bigtreetech/Raspberry-Pad/Pad5/3D/README.md

* The fixing screw  of the screen is M2.5x6mm
* The fixing screws of the upper and lower covers are three M3x6mm countersunk screws and hex nuts
