bigtreetech/Raspberry-Pad/Pad5/3D/Pad5+Case.STEP

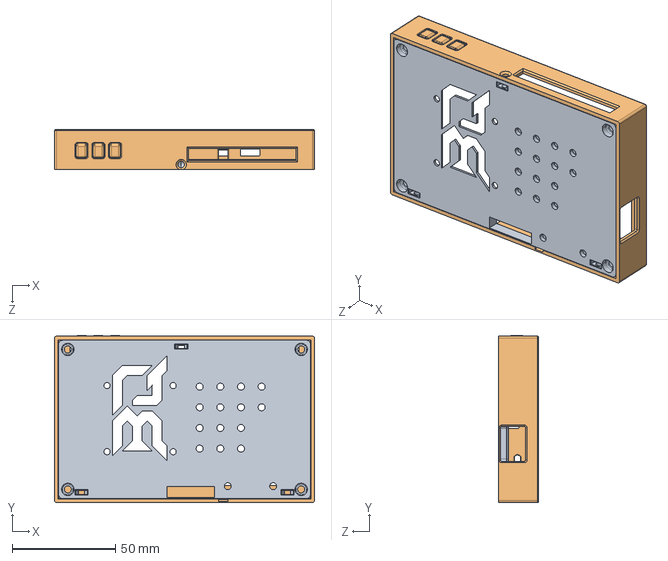
[picture p17: CAD file, 2022-09-15]
Pad5/3D/Pad5+Case.STEP
125.9 x 81.1 x 19.5 mm
