bigtreetech/Raspberry-Pad/(threads)

Thread 1 (2022-03-26):

GPIO pinout

cakeslob, 2022-03-26:
Can you provide some kind of pinout document or some label for the 40 pin GPIO? A document would be helpful, thank you.

jrgGearbox3d, 2022-04-05:
I am also looking for this.  The manual states to hook 5V to Pin 40, which is not typically the GPIO layout for a CM4 / PI.  Based on this I would guess that the pins are numbered backward from a typical 40PIN PI GPIO.

It would be nice to see the real GPIO and circuit before smoking a nice IPS screen.

bigtreetech, 2022-04-07:
Hello, https://github.com/bigtreetech/Raspberry-Pad/commit/2a0127b8a28db4e08ce698afd2b463529ae75a97 have updated the the pin out description of 40 pin GPIO on manual, Please check.

Closed 2022-04-10.

Thread 2 (2022-04-02):

EEPROM_NW Switch Use.

madmaxed, 2022-04-02:
Is there information on what the EEPROM_NW switch is used for?  I don't see reference to it in any of the documentation.

othermod, 2022-04-05:
It's the EEPROM write protect. Check out section 2.18 in the link below
[https://datasheets.raspberrypi.com/cm4/cm4-datasheet.pdf ](https://datasheets.raspberrypi.com/cm4/cm4-datasheet.pdf )

Thread 3 (2022-04-15):

Control Display Backlight?

lalten, 2022-04-15:
Hi, how can I control the Raspberry Pad 5's display backlight and power?

I'm on `2022-04-04-raspios-bullseye-arm64-lite` with Kernel 5.15.32-v8+, running KlipperScreen (installed via [kiauh](https://github.com/th33xitus/kiauh))

```
❯ cat /boot/config.txt | grep "^\w"
dtparam=spi=on
dtparam=audio=on
camera_auto_detect=1
display_auto_detect=1
dtoverlay=vc4-kms-v3d
max_framebuffers=2
arm_64bit=1
disable_overscan=1
otg_mode=1
arm_boost=1
dtoverlay=dwc2,dr_mode=host
dtparam=i2c_vc=on
dtoverlay=i2c-rtc,pcf8563,i2c_csi_dsi
```
`/boot/dt-blob.bin` is also installed as per the manual.

A sysfs entry is present:
```
❯ ls /sys/class/backlight/10-0045/
actual_brightness  bl_power  brightness  device  max_brightness  power  scale  subsystem  type  uevent
```
But sending commands has no effect. (using [rpi-backlight](https://github.com/linusg/rpi-backlight)):
`sudo rpi-backlight -p off /sys/class/backlight/10-0045`
Display stays on and at 100% brightness...

Darkgoppi, 2022-09-01:
I have the same behavior as described by lalten. I tried to switch the back light power by manipulating the `bl_power` file in `/sys/class/backlight/10-0045/` based on the status of xscreensaver. Is there any way to control the back light brightness and power?

Darkgoppi, 2022-09-10:
Hi, I contacted the BIQU support on this issue/question. This is the answer from them:

"Sorry, no. This is a constant light that the screen lights up."

So it seems, that it is not intended to control the backlight at all, which is a pity.

sl1pkn07, 2023-04-23:
and via buttons hardware? (three in the corner)

kbenyous, 2024-03-28:
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

Hello,
According to their technical docs ( schematics https://github.com/bigtreetech/Raspberry-Pad/blob/master/Pad5/Hardware/BIGTREETECH%20Raspberry%20pad%205-SCH.pdf ) the 3 hardware buttons (BRI+, BRI- and LCD_DIR) are plugged to some pins of a ARM Cortex M0 MCU. So it could be software-controlled, if BTT would implement it in the firmware of this MPU !

Thread 4 (2022-05-15):

does not show on network

Machine73, 2022-05-15:
Purchased 2 pad5's and neither will connect to network. SD cards with os installed work perfectly in a standard PI. But once installed in the PAD5 no connection,

othermod, 2022-05-15:
It is the wired LAN port you're having trouble with? I've been using one of these for a while and I have it wired to a decent network switch that works fine with it. I recently tried using it with a cheap switch, and it can't get an IP address with it connected to that switch. Running ifconfig just shows a standard 169.254 address.  Just curious whether we are having the same problem.

Machine73, 2022-05-15:
No. Over wifi. And they are the CM4 w/ wifi.

blooest, 2022-05-18:
You haven't really given us any information. My best guess is that you got a CM4 with eMMC that will not boot at all from SD. Connect an HDMI display so you can see what's going on with it. Other than that, the CM4 wifi has nothing at all to do with the Raspberry Pad so you're probably better off seeking information from a more generalized/larger RPi community.

@othermod To note, I'm here chasing the same problem. The switch I'm working with is a known-good Unifi box, though. It's detecting the client, providing an activity light on its end, but I get a whole lot of nothing on the Pi side and then a 169.254 zeroconf address. Was beginning to think the port was dead, but I guess I'll have to move things around and try another switch. Maybe we should open a separate issue?

jstebbins, 2022-08-19:
Confirming same behavior as @blooest. I am also connected to a Unifi switch (model US-8-60W). Fails to link at GB speed, but forcing link to 100BASE-T works.

When failing to link at GB speed, I see an initial attempt to bring the link up in the system logs, then the link goes down and does not connect.  The green light on the ethernet connector of the Raspberry Pad blinks at a slow regular interval.

blooest, 2022-08-19:
@jstebbins Sorry, I actually never circled back to this thread -- BTT support actually did solve that issue for me; in the end, I had to [physically desolder three SMD components on the board](https://imgur.com/a/lClHPaa), but the gigabit PHY worked flawlessly afterwards. Hope that helps!

jstebbins, 2022-08-19:
@blooest Thanks! Did they provide any additional details regarding the nature of the problem? Do those components affect any other functionality? Would hate to fix one thing only to render something else non-functional :grin:

blooest, 2022-08-19:
@jstebbins They weren't _too_ particular to me as an end user, but as long as you _only_ touch those three, it shouldn't affect anything else. They're resistors across the traces from the Magjack to the breakout for the PHY on the CM4. They don't physically interact with any other components. From what I've inferred (read: **I'm just another customer making educated guesses**), they have/had multiple suppliers for the Magjack itself, and the ones they prototyped with didn't have resistance built in, which led them to add these resistors, but the ones they shipped, at least to the two of us, do, and that extra resistance is causing this issue.

jstebbins, 2022-08-19:
> the ones they prototyped with didn't have resistance built in, which led them to add these resistors, but the ones they shipped, at least to the two of us, do

Ahh, that makes sense. Seen that happen before. Thanks for passing along the info.

jaymcd, 2022-10-25:
I have no wifi either - error on boot says bcrm_pci link down

FriendlyNGeeks, 2024-07-26:
> @jstebbins Sorry, I actually never circled back to this thread -- BTT support actually did solve that issue for me; in the end, I had to [physically desolder three SMD components on the board](https://imgur.com/a/lClHPaa), but the gigabit PHY worked flawlessly afterwards. Hope that helps!

I cant believe this worked, but it makes sense from a prototype!!!! Nerve wrecking getting those itty bitty resistors

Thread 6 (2022-06-21):

pinout documentation missing

troyness, 2022-06-21:
I want to connect my hardware to a CAN bus. There is no documentation on what the USB C input pinout is to do this. Sent an emails to support over the past few weeks with no response.

pnewb, 2022-12-01:
If you get a usb breakout board, you can grab the standard usb2 data pins and they'll be your CANH and CANL.  Can't recall which is which right now, but you have a 50/50 chance of getting it right, and if it's not right you won't damage anything.

It's a bit awkward because this is the same port you use to power the pad.  So having the breakout can be doubly helpful as you'll want to supply power in one direction, and run CAN in the other.

Thread 7 (2022-08-02):

CM4 2gb lite version, raspios, and usb ports

jaymcd, 2022-08-02:
I have the PAD 5 - I finally managed to get a CM4 ( 2GB lite version) I managed to get RaspiOS ( Raspian) installed. Even after following the instructions in the manual - including the overlay stuff I cannot for the life of me get the USB ports to be usable. Wondering what I am missing

OAltr, 2022-08-17:
Hi @jaymcd I had the exact same problem. What fixed it for me was setting the BOOT and BOTG switches to their off position. Had them on because I previously used a CM4 with eMMC.

brunoAmado, 2022-09-03:
installng [Fluiddpi 1.19](https://github.com/fluidd-core/FluiddPI/releases/tag/v1.19.0) using LITE Version(Micro SD card)
ssh already in image
add wpa credencials in fluiddpi-wpa-supplicant.txt
configure USB 2.0 Hub in config.txt file
verification of microswith (all off)
result:
Red light and Blue but no Green :(

Did I miss something ?

pl4nkt0n, 2022-09-04:
As described in the data sheet of the CM4 from Pi-Foundation and in the manual from BigTreeTech:

"With the Raspberry Pi OS the following has do be done to activate the USB-Ports for the CM4: To enable the USB 2.0 ports on the Compute Module 4, you need to edit the boot config file (/boot/config.txt) and add with the last row:

dtoverlay=dwc2,dr_mode=host

It is deactivated by default in the OS of RaspiOS to save energy.

brunoAmado, 2022-09-05:
Hi,

As I said in the last mail. I did the configuration as explained in the
BigTreeTech Manual.
Please see the attachments and video.

https://drive.google.com/file/d/1MA2Fw5SE6T7sgGQLoNIgWznggDXRX3d6/view?usp=sharing

Best Regards,

Bruno

---------- Forwarded message ---------
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

brunoAmado, 2022-09-06:
```
# For more options and information see
# http://rpf.io/configtxt
# Some settings may impact device functionality. See link above for details

# uncomment if you get no picture on HDMI for a default "safe" mode
#hdmi_safe=1

# uncomment the following to adjust overscan. Use positive numbers if console
# goes off screen, and negative if there is too much border
#overscan_left=16
#overscan_right=16
#overscan_top=16
#overscan_bottom=16

# uncomment to force a console size. By default it will be display's size minus
# overscan.
#framebuffer_width=1280
#framebuffer_height=720

# uncomment if hdmi display is not detected and composite is being output
#hdmi_force_hotplug=1

# uncomment to force a specific HDMI mode (this will force VGA)
#hdmi_group=1
#hdmi_mode=1

# uncomment to force a HDMI mode rather than DVI. This can make audio work in
# DMT (computer monitor) modes
#hdmi_drive=2

# uncomment to increase signal to HDMI, if you have interference, blanking, or
# no display
#config_hdmi_boost=4

# uncomment for composite PAL
#sdtv_mode=2

#uncomment to overclock the arm. 700 MHz is the default.
#arm_freq=800

# Uncomment some or all of these to enable the optional hardware interfaces
#dtparam=i2c_arm=on
#dtparam=i2s=on
#dtparam=spi=on

# Uncomment this to enable infrared communication.
#dtoverlay=gpio-ir,gpio_pin=17
#dtoverlay=gpio-ir-tx,gpio_pin=18

# Additional overlays and parameters are documented /boot/overlays/README

# Enable audio (loads snd_bcm2835)
dtparam=audio=on

# Automatically load overlays for detected cameras
camera_auto_detect=1

# Automatically load overlays for detected DSI displays
display_auto_detect=1

# Enable DRM VC4 V3D driver
dtoverlay=vc4-kms-v3d
max_framebuffers=2

# Disable compensation for displays with overscan
disable_overscan=1

[cm4]
# Enable host mode on the 2711 built-in XHCI USB controller.
# This line should be removed if the legacy DWC2 controller is required
# (e.g. for USB device mode) or if USB support is not required.
otg_mode=1

[all]

[pi4]
# Run as fast as firmware / board allows
arm_boost=1

[all]
# enable raspicam
start_x=1
gpu_mem=128
dtoverlay=dwc2,dr_mode=host

```

jaymcd, 2022-10-20:
still cannot get by usb ports to work. I even sent my cm4 back and they sent a new one... ???
pios installed screen working but getting usb to work - not so much. I am usb the USB-C for power does that matter ? It is plugged into a powered USB.

OAltr, 2022-10-20:
Just noticed this section in you config:

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

I'll have to check on my setup tomorrow, but I don't remember a cm4 section in mine. Maybe removing the org_mode=1 could help.

In the past I had a problem when adding any commands below a section (e.g. [cm] or [all]) and had to add it above any of those (but this might be a non issue and it used to be a different problem back then 😄)

jaymcd, 2022-10-25:
No USB or Wifi. Moved my CM4 over to a CMIO module board - USB works fine but not WIFI ( obviosuly a broadcom driver issue).
There is either something wrong with my PAD 5 or the instructins are incorrect. I have tried everything suggested to no avail. Anyone havea working image?

Thread 9 (2022-09-04):

STEP File corrupted?

pl4nkt0n, 2022-09-04:
Tried to open the [Pad5+Case.STEP] but it seems to be defect. No CAD program  and no STEP viewer (even online) can open it.
Can you please fix that?

Thread 11 (2022-11-17):

Unable to get the DSI1 Port working for the screen getting 404 error

dborio, 2022-11-17:
When I try to run the command from step 4.2 sudo wget https://datasheets.raspberrypi.com/cmio/dt blob disp1 cam1.bin O /boot/dt blob.bin I am getting a 404 Site not found error.  Please help.

lohriialo, 2024-11-24:
copy paste issue from PDF to terminal
Btw, firmware has moved to `/boot/firmware/dt-blob.bin` from `/boot/dt-blob.bin`
Following should work for anyone trying in 2024 on CM4 with Raspbery Pad 5
```
sudo wget https://datasheets.raspberrypi.com/cmio/dt-blob-disp1-cam1.bin -O /boot/firmware/dt-blob.bin
sudo reboot
```

Thread 13 (2023-01-07):

USB-C CAN bus Pinout Missing

Engineer997, 2023-01-07:
There isn’t a pinout diagram for the Raspberry Pad 5.
What pins are used for the CAN bus?

Engineer997, 2023-01-07:
Asked Previously. A comment stated it is the USB2 pins. I have not tested.

Pinout Diagram still missing please add for users.

Closed 2023-01-07.

Thread 15 (2023-04-25):

Make it compatible with Pine64 SOquartz (RockChip rk3566) CM4

sl1pkn07, 2023-04-25:
Hello.

i have this board and the BTT pad 5 unit. i have installed manjaro ARM in the 16GbeMMc

"all" works as spected. ETH(gigalan, this is fixed in my unit https://github.com/bigtreetech/Raspberry-Pad/issues/4 ), Wifi/BT (after little patch), USBs, HDMI etc.... all except the CSI (not tested) and the DSI1 display

any help how i make to work the Display?

greetings

sl1pkn07, 2023-04-28:
ping @bigtreetech (?)

greetings

Thread 16 (2023-05-22):

schematic ?

nathmo, 2023-05-22:
hey, would it be possible to release the schematic of the board ?
a PDF on this repo would be nice

sl1pkn07, 2023-05-27:
and display datasheet. 0500a800 (need to be edit)  not exist in the market (for replace spare part

greetings

gamelaster, 2023-07-31:
@bigtreetech any updates?

gamelaster, 2023-08-06:
https://github.com/bigtreetech/Raspberry-Pad/blob/master/Pad5/Hardware/BIGTREETECH%20Raspberry%20pad%205-SCH.pdf

Closed 2023-11-12.

Thread 17 (2023-10-31):

CAN connection not working.

Engineer997, 2023-10-31:
I am running Raspberry Pi OS Debian Bullseye, Klipper, KlipperScreen, Mainsail, and Moonraker.

The CAN bus does not connect to my Octopus or Hermit Crab Can edition. This is not an issue when using a Raspberry Pi 4 B and a CAN Hat with the same Config files. I have CANH/CANL connected to the USB D+/- connections from the USB-C port on the Raspberry Pad 5 with the dip switch for CAN on the on position and the switch for the CAN connection in the correct position as per the manual.

Engineer997, 2023-11-09:
User manual for raspberry pad 5 needs a revision to include an additional step for setting up the CAN bus after the current last step “ MCP2515 is operating，correct return should be as following：
[ 8.680446] CAN device driver interface
[ 8.697558] mcp251x spi0.0 can0: MCP2515 successfully initialized.
[ 9.482332] IPv6: ADDRCONF(NETDEV_CHANGE): can0: l"

the section that needs to be added is as follows:
Input sudo nano /etc/network/interfaces.d/can0 command to create a new file named can0, and write the following content
auto can0
iface can0 can static
    bitrate 250000
    up ifconfig $IFACE txqueuelen 1024

Thread 18 (2023-10-31):

Raspberry Pad 5 with KlipperScreen touch not working when rotated,

Engineer997, 2023-10-31:
I am running Raspberry Pi OS Debian Bullseye, Klipper, KlipperScreen, Mainsail, and Moonraker.

When using KlipperScreen the touch screen does not work when rotated 180 degrees using the middle button on the Raspberry Pad 5. How can this be rectified?

Closed 2023-11-07.

Thread 20 (2024-01-14):

Unable to Access eMMC

rebeltaz, 2024-01-14:
I am trying to access the eMMC and I cannot get this to connect. I have a Raspberry Pi Pad 5 v1.0 with a Raspberry Pi Compute Module 4 - both of which were given to me. The Pi Pad and CM4 boots up fine, klipper runs and the touchscreen works. I followed the directions in the manual - namely "Set switch 1（USBOTG） and switch 2（BOOT）to On position(to the left) to enter BOOT mode. Double check that Type-C port is in USB mode" and I run ./rpiboot (under Ubuntu 22.04LTS). The prompt just sits there "Waiting for BCM2835/6/7/2711..."

Can someone help me figure out what I am doing wrong?

rebeltaz, 2024-03-12:
No?

Thread 23 (2025-03-30):

Can't Boot From SD Card

leewiscovitch, 2025-03-30:
I've been trying to get the Pad 5 working with a CM4 Lite (4GB + WiFi) and just can't seem to get SD booting to work.

I can burn the official image to a USB device and it boots/works (Installed display driver, buttons work, touchscreen, etc).

But when I burn that same image to (several known good) SD cards it just boots to the boot menu and cycles through the options. I says can't find SD card...

I checked the dip switches, they are all to the right, and I've tried both positions of the other switch.

When I boot with SD card it says `Failed to open device: `sdcard` (cmd 371a0010 status 1fff0001)` which from what I can find googling it says it's either bad SD card or reader...But these cards (five different ones) work on several other rpi's and carrier boards so it can't be that.

The Pad 5 does support CM4 Lite right?

I should also mention when I'm at the boot menu it's showing `bootloader: 8ba17717 2023/01/11` which I don't think is the most recent but still sorting out how to fix that.

Any info would be greatly appreciated!!!
