bigtreetech/Raspberry-Pad/Pad5/Hardware/BIGTREETECH Raspberry pad 5-SCH.pdf

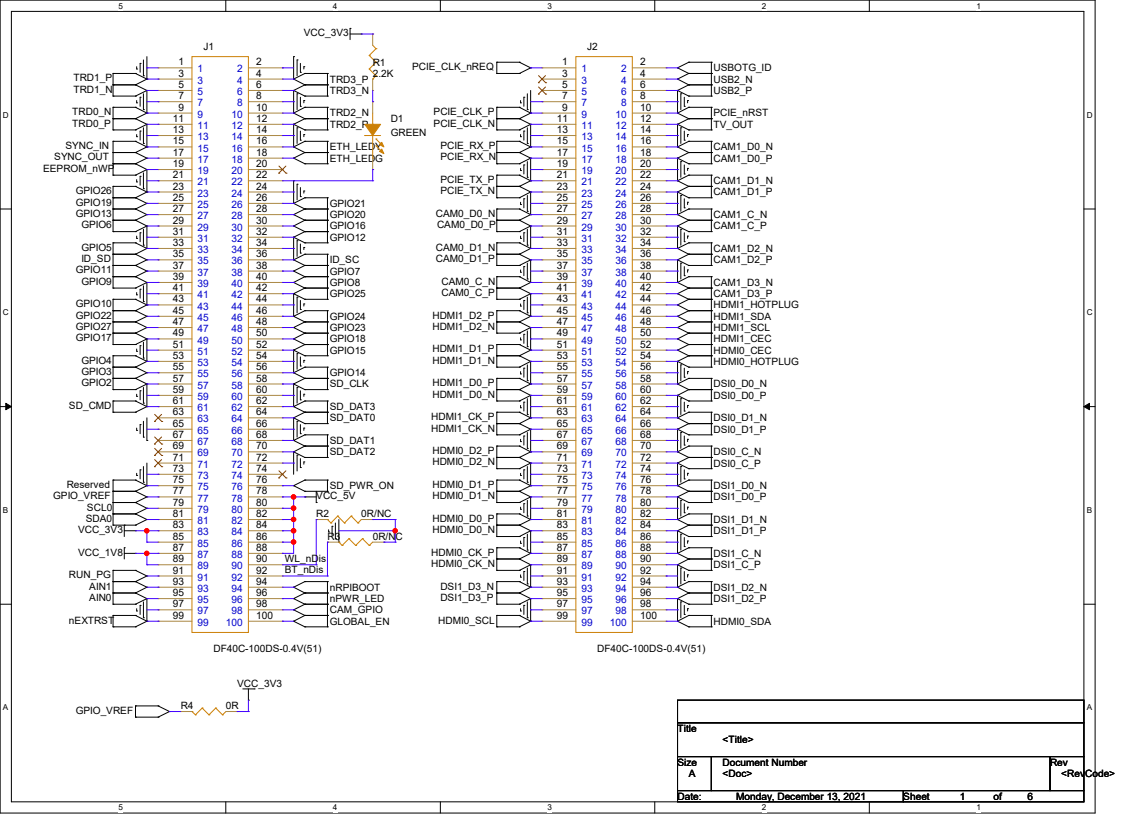
[picture p18: page 1]
PCIE_CLK_nREQ; USBOTG_ID; TRD1_P; TRD3_P; USB2_N; TRD1_N; TRD3_N; USB2_P; TRD0_N; TRD2_N; PCIE_CLK_P; PCIE_nRST; TRD0_P; TRD2_P; PCIE_CLK_N; TV_OUT; SYNC_IN; ETH_LEDY; PCIE_RX_P; CAM1_D0_N; SYNC_OUT; ETH_LEDG; PCIE_RX_N; CAM1_D0_P; EEPROM_nWP; PCIE_TX_P; CAM1_D1_N; GPIO26; PCIE_TX_N; CAM1_D1_P; GPIO19; GPIO21; GPIO13; GPIO20; CAM0_D0_N; CAM1_C_N; GPIO6; GPIO16; CAM0_D0_P; CAM1_C_P; GPIO12; GPIO5; CAM0_D1_N; CAM1_D2_N; CAM0_D1_P; CAM1_D2_P; GPIO11; GPIO7; GPIO9; GPIO8; CAM0_C_N; CAM1_D3_N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

# SHIELD2 16 YELLOW⁺ ¹⁴ YELLOW⁻ ¹³

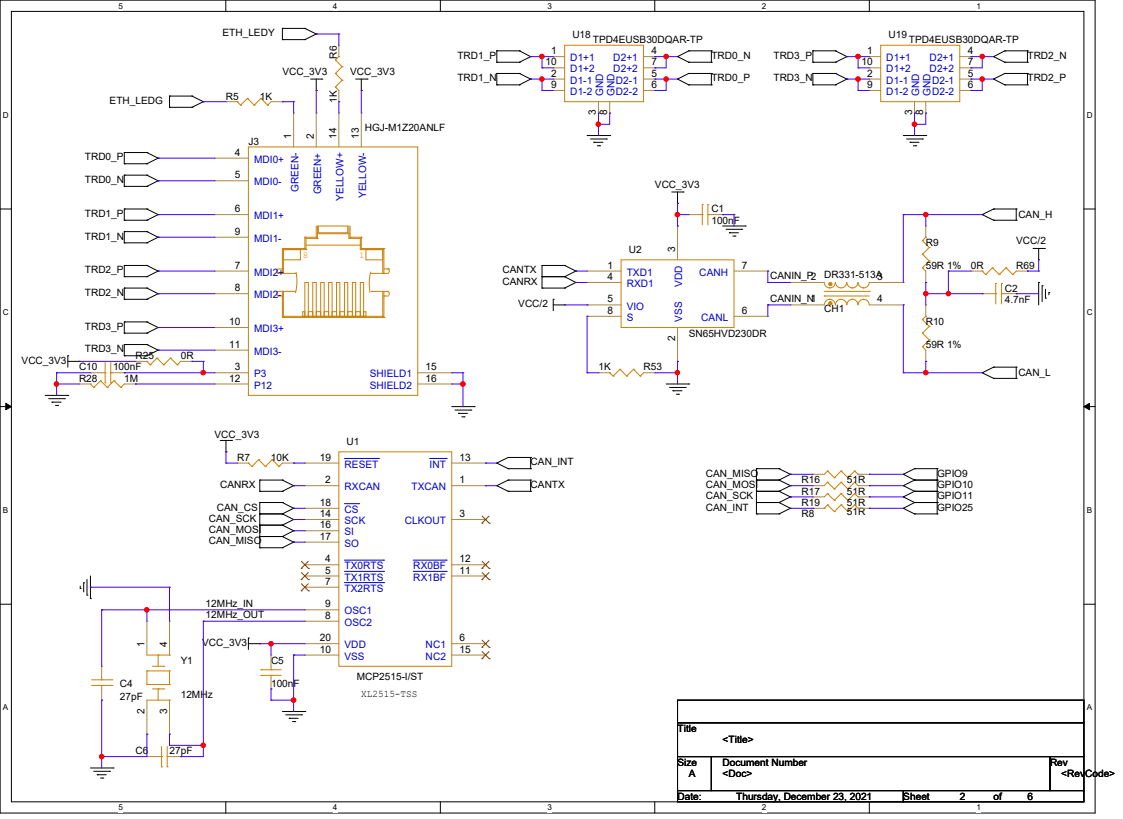
[picture p19: page 2]

# SDA0 SCL0 EEPROM_nWP

15 15 | 16 | 16 17 | 17 18 | 18 19 | 19 20 | 20 21 | 21 22 | 22 23 | 23 24 | 24 25 | 25 26 | 26 27 | 27 28 | 28 29 | 29 30 | 30

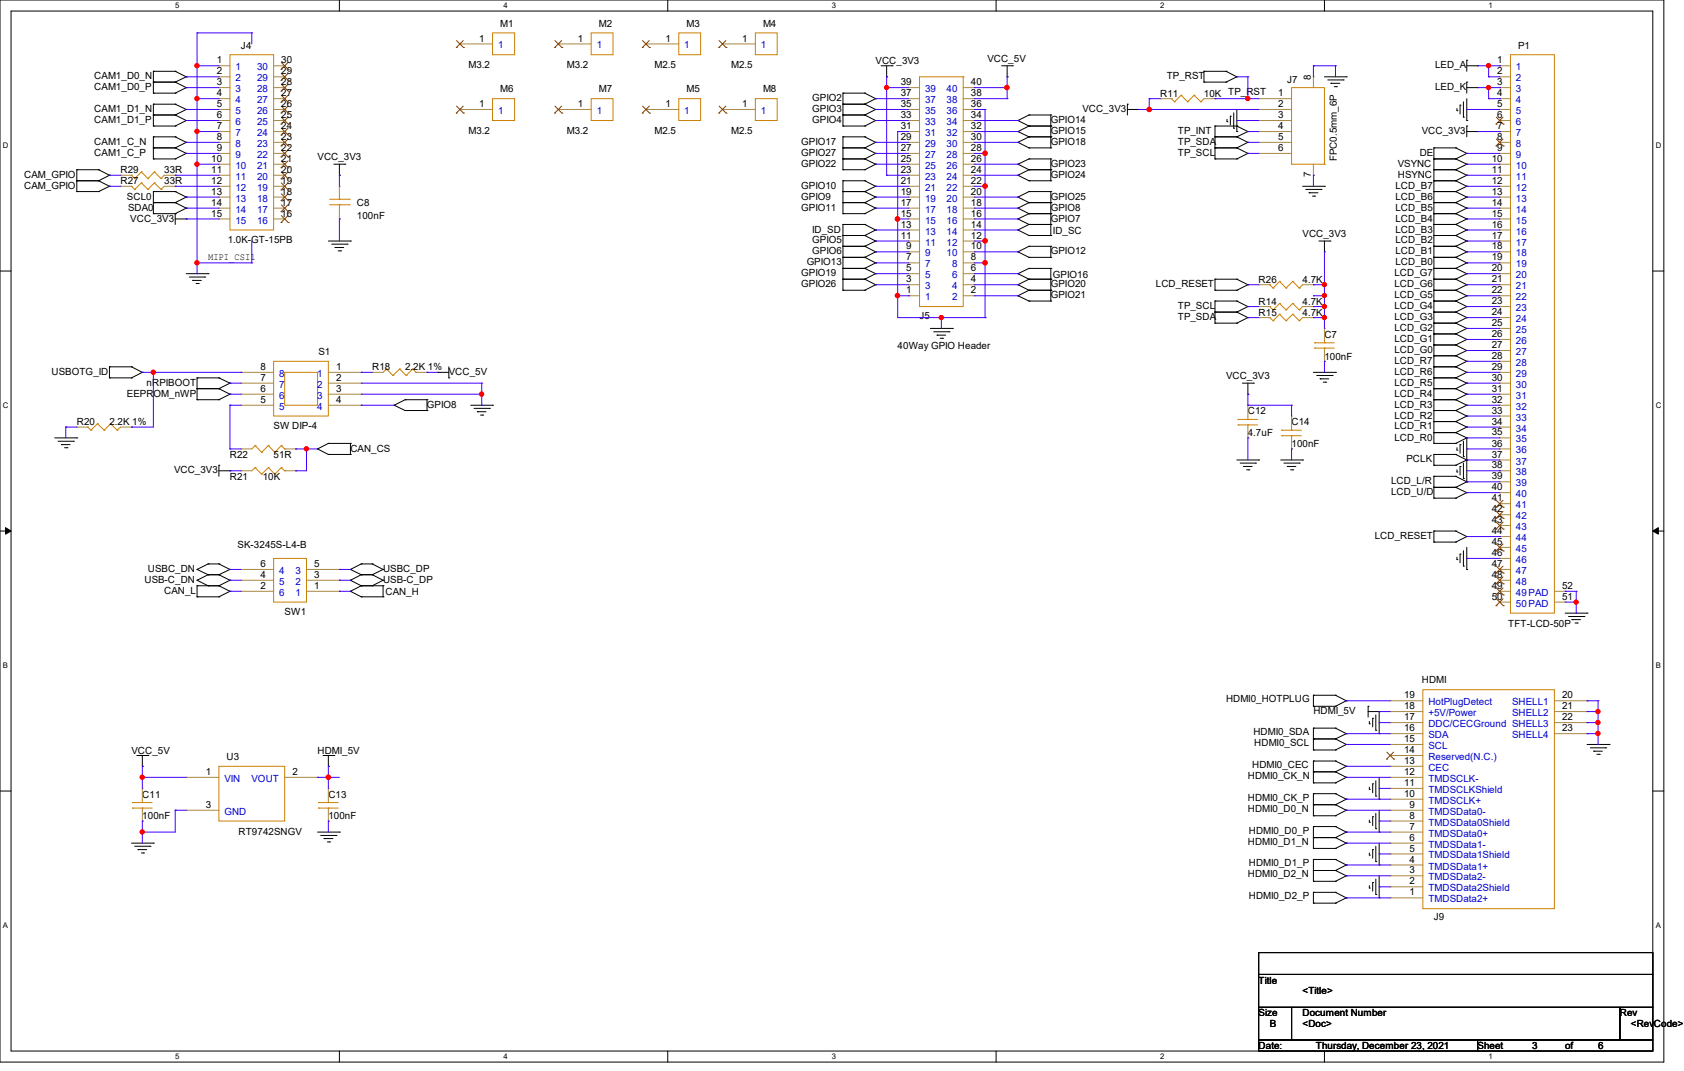
[picture p20: page 3]

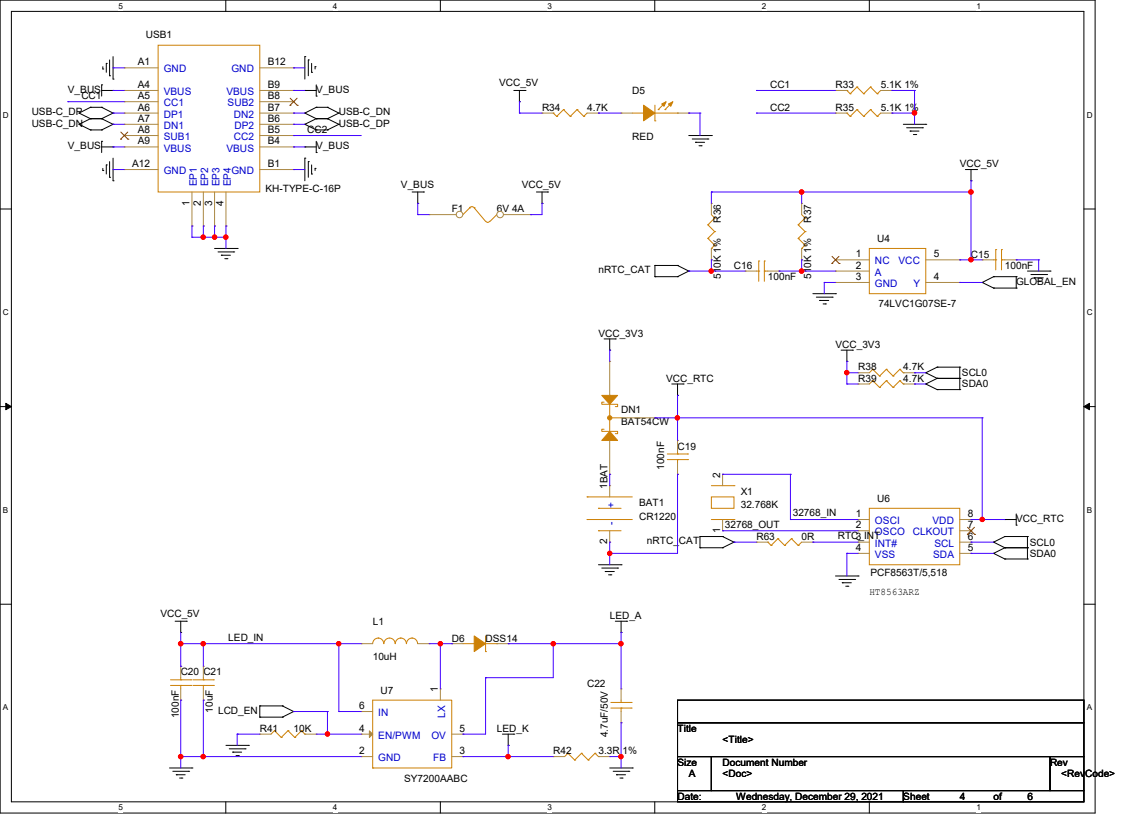
[picture p21: page 4]

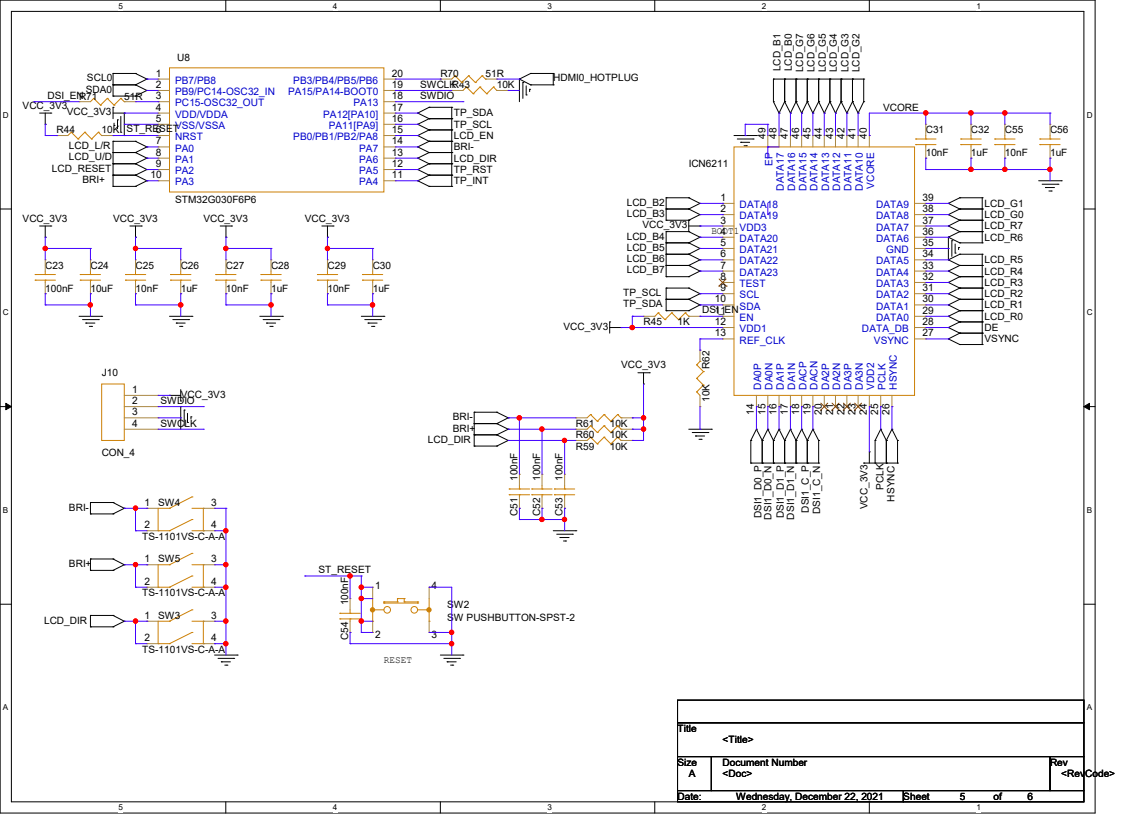
[picture p22: page 5]

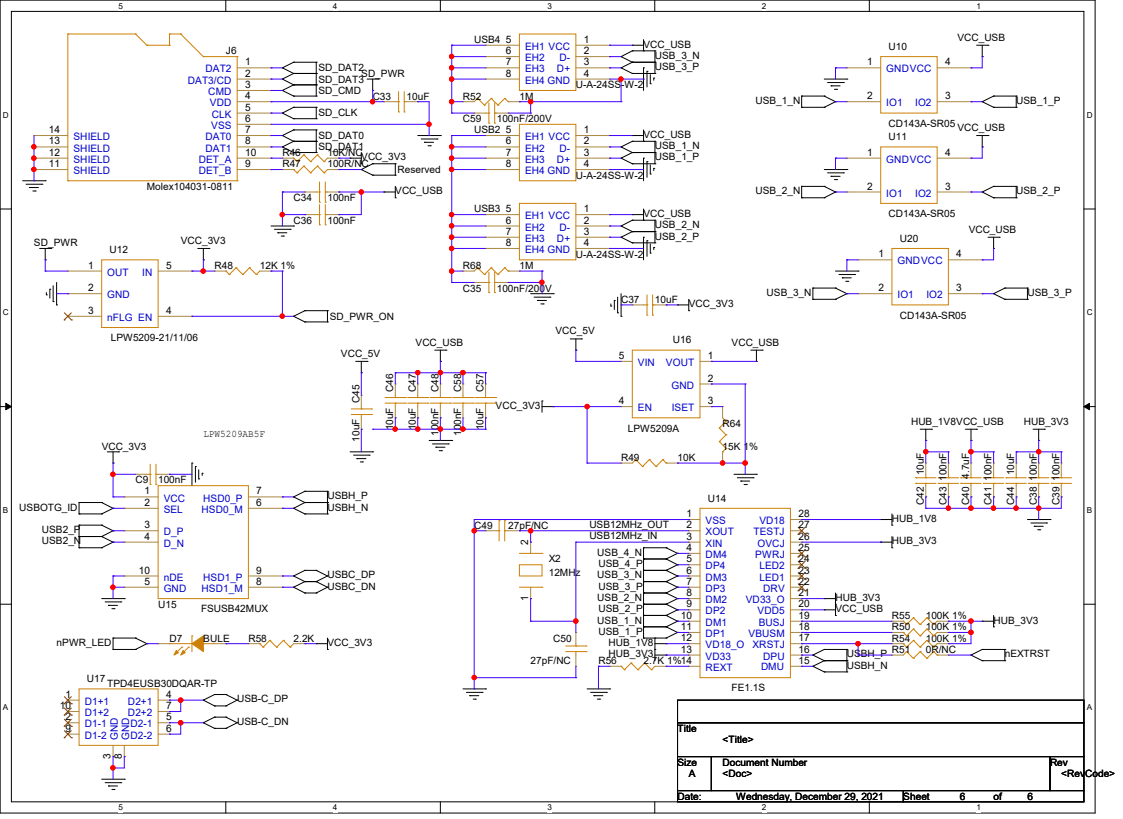
[picture p23: page 6]

ISET 3 EN 4
DPU 16 XRSTJ 17 VBUSM 18 BUSJ 19 VDD5 20 VD33_O 21 DRV 22 LED1 23 LED2 24 PWRJ 25 OVCJ 26 TESTJ 27 VD18 28
