bigtreetech/Raspberry-Pad/Pad5/Hardware/BIGTREETECH Raspberry pad 5-SIZE.pdf

# ART FILM - SIZE

8.275

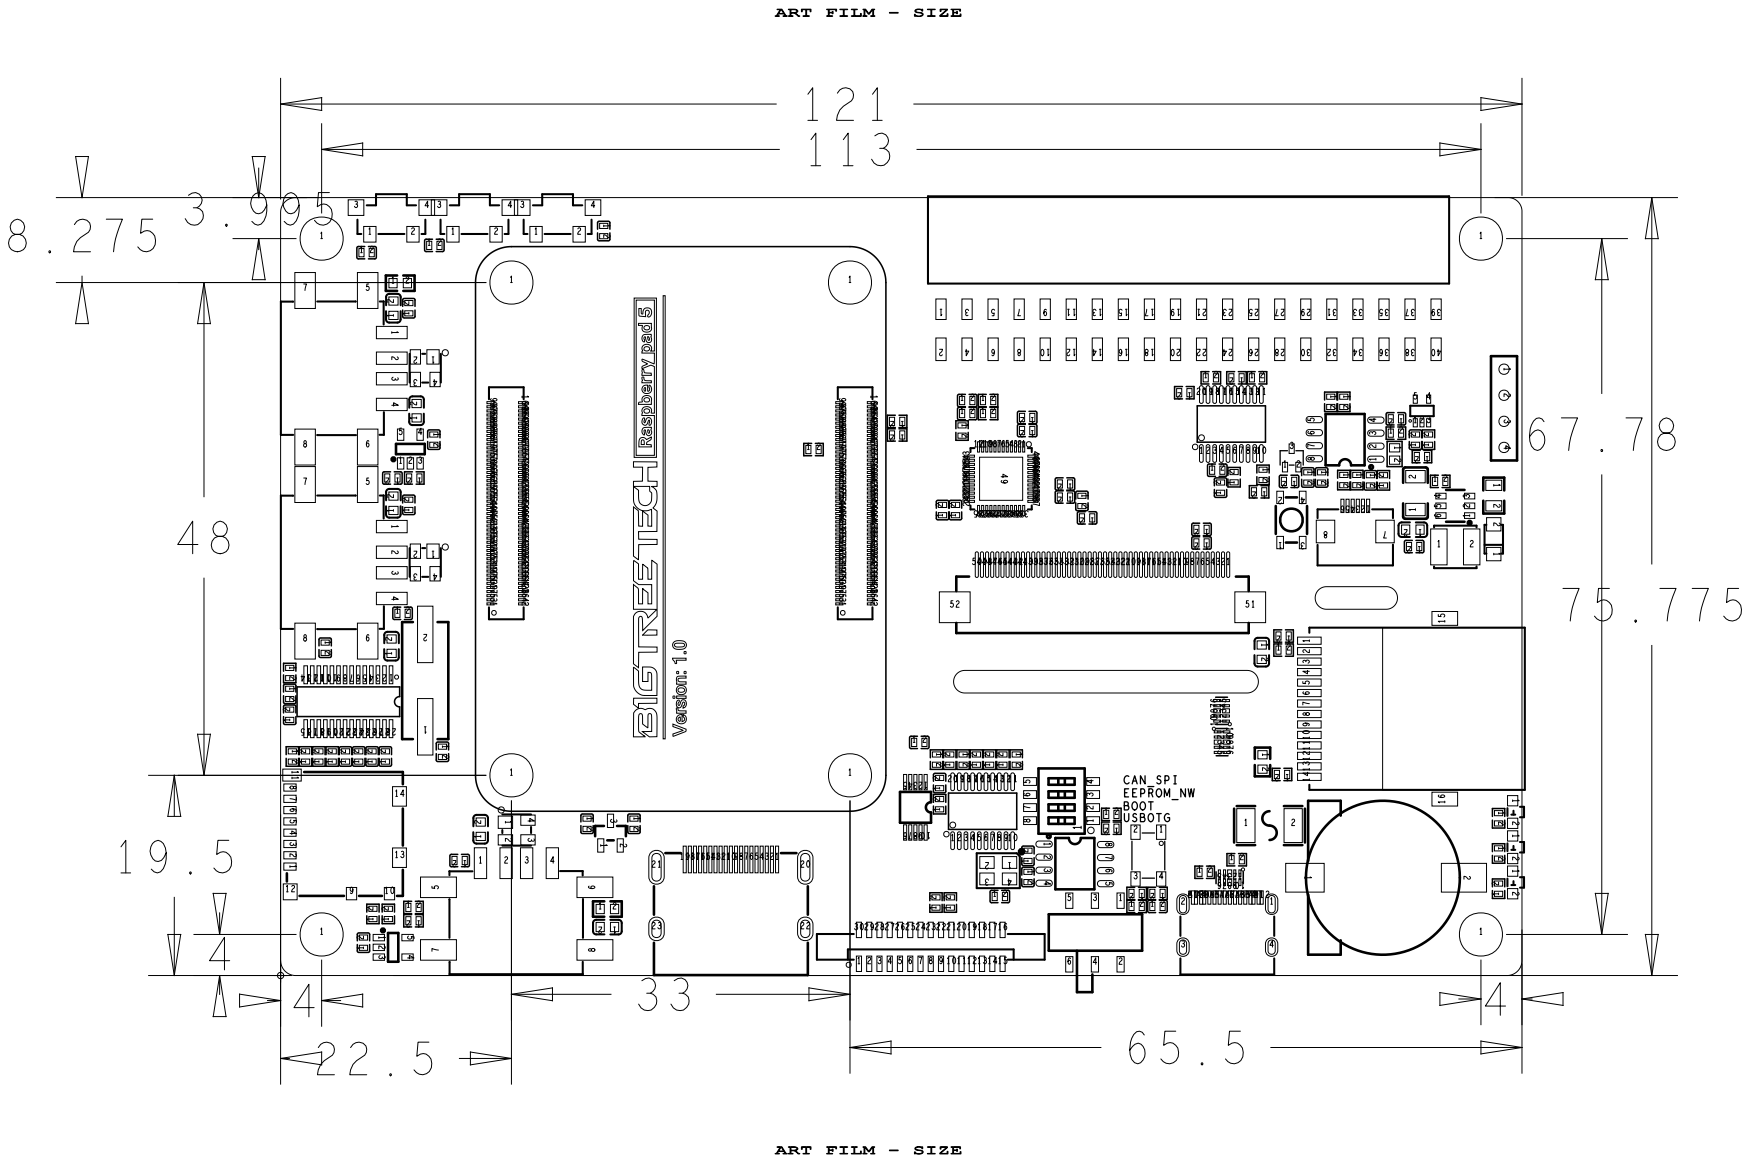
[picture p24: page 1]
434241403938373635 ⁴⁰³⁹³⁸³⁷; USBOTG; CAN_SPI EEPROM_NW BOOT

ART FILM - SIZE
