bigtreetech/Raspberry-Pad/(commit log)

2022-09-15 rebase init
    [Pad5+Case.STEP]
2024-12-21 The path of the new Raspberry Pi system has been changed from '/boot/' to '/boot/firmware'
2025-03-27 manual: Raspberry Pi 2023-10-10 and later systems, the configuration path changes from '/boot/' to '/boot/firmware'
